AbhinavA10/PS2-RC-Car/docs/Sources/Interfacing a PS2 (PlayStation 2) Controller - CuriousInventor Tutorials_files/annotated_scope.jpg

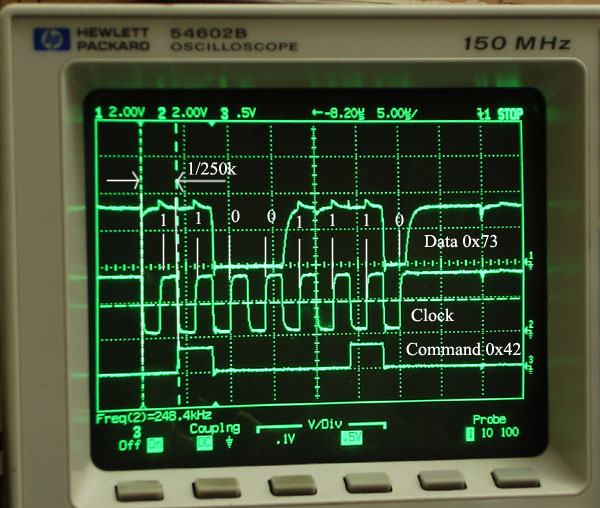
docs/Sources/Interfacing a PS2 (PlayStation 2) Controller - CuriousInventor Tutorials_files/annotated_scope.jpg
