AbhinavA10/PS2-RC-Car/docs/MyNotes/Peripherals on Pins.PDF

## vpn I qL5 1- ffr+ :-

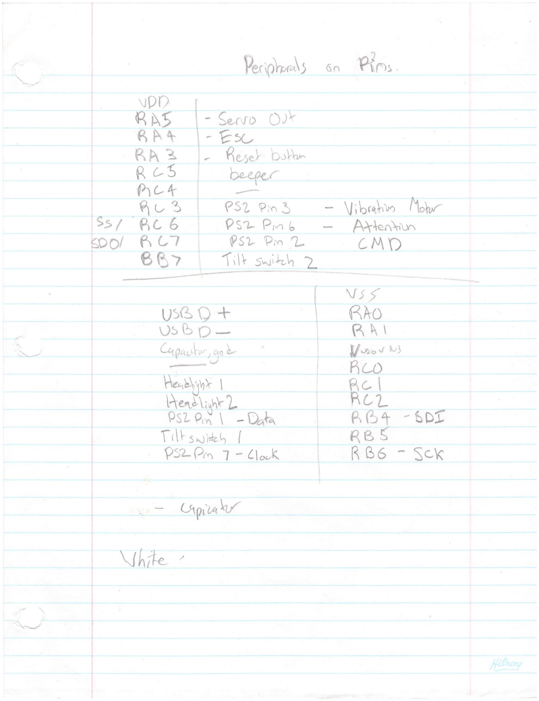
[picture p14: page 1]

F**iphr-\1 Gn Pin,

&h ?. ',-
Ro5
f,\u+

## flu3 5s/ ftc 6

6DC/ fl\ L-l
B [::

Se-r';c O;k
t>t-.
ff a:" i (-.rI)'r,^ 'ry-

P5? P;", $
P sr- Prvr b
fls:. Pin, L
{i\t s*,ii U\ Z

V tbrq!,),r l\"|r"
A\l*nXrn
TMD

-4J
u5eQ+ U:b6l*

(ta,p,,r'\.'
i -\rr c'
*_/

-.P@'i
\4c,,t\rUh I
r\ U
Retf \tnhk L
Fslo,; \ -%l4
fi\f s^.,j*.q t
F:z-P,"r T d (lo,K

(Apit<\f

v5 5"
Rho R\\

$/*, a,I \, )
fiuo
Rct Rr-L

fi t?r t '4 SDt
Re 5
R B5 SCK

V[t* /
