AbhinavA10/PS2-RC-Car/docs/MyNotes/SchematicNotes.PDF

-r

/, | r-t

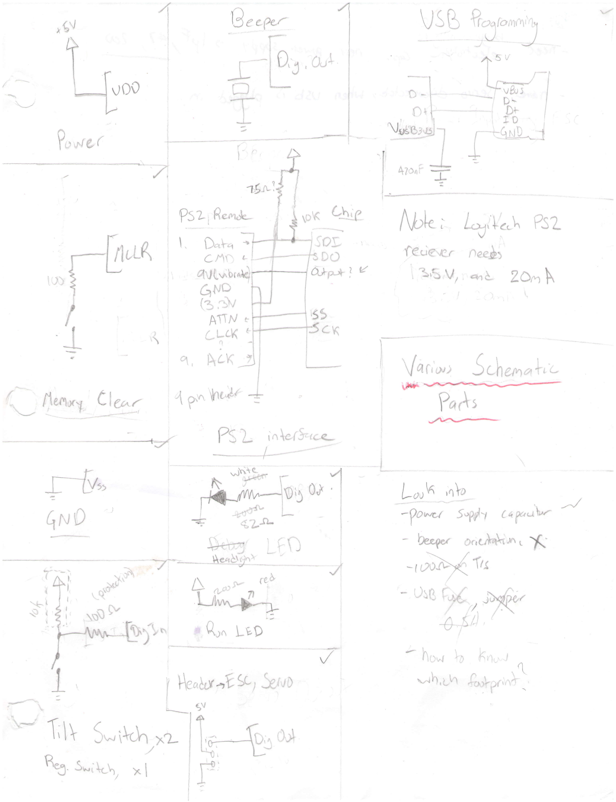
[picture p15: page 1]

t ⁻*i C. li\)

I

n L''

I
t_
\v't//\
,lf ,iq

I

1,'-l

I

r l5ee?.

i

## lI*rl

l. D.,t". ;
C /lt', e- i.
\
{,Jfrabrak)

## VSB

## AlrU ; l-v,'l-c,L Ps?

### feuie"cr nee6:

' A,S,V1. "a4* ZCn", h

l

I

I i l^-. | { i | 1

### ' V Q(i*i )Chen{,,ttt'*

i'f*r o\ t'al5

:\

I

I | ln | \

## lolt -l'i

rq

### 'fo,^a1 S"?d-t tey*rVr

lrk"ryt
-\/

,sr,ul-4\i,.s\ r X

## -rro}-{ Ttl

1-\^i.,{\irW '-1 l-i} t
n
\,/1'\\ vlQ,it1,l-rl1Lu)rr,\4

_

?o*te'(
' '
"-lt
-f.L n-:il I
vJ' | fi
,orr D- t | I J
'Y>L nelvldk"- t J -i | 1e

{
'r, I
i
t
1
:

D"q

i
\

Gt'l? (3 ,..$y'

ATTN

### LLtx

q, hcK'

't ?* htdr

,55
cK

4
0"I'l

t{
f-&"

### / r'rrl ) q/v L/

# &q .it)

:_

* _. Ar4L$: _* -

.-\ )'t'
..idt | + p:'n-n tu'o
1Q'" | | ;"- -n
- 1.. | LJtv\^-+-f-
\\U | ,' -
}ir" .* Ron LED

/
J'
I

\
\ | -r | -{, \:# -\"\t | / | . ,

# lr lt )* iloh

A

I

I
,C,,

I

I
I

I
I
I
I
,' -l

## \oK tIif

'>

15rl! \
*F n0
1o,*r** | s

## ;Yhr

| ile-i
*r
i
)\L

## I R? s*;L\, x I

### ntSL, ftr,;)

,,

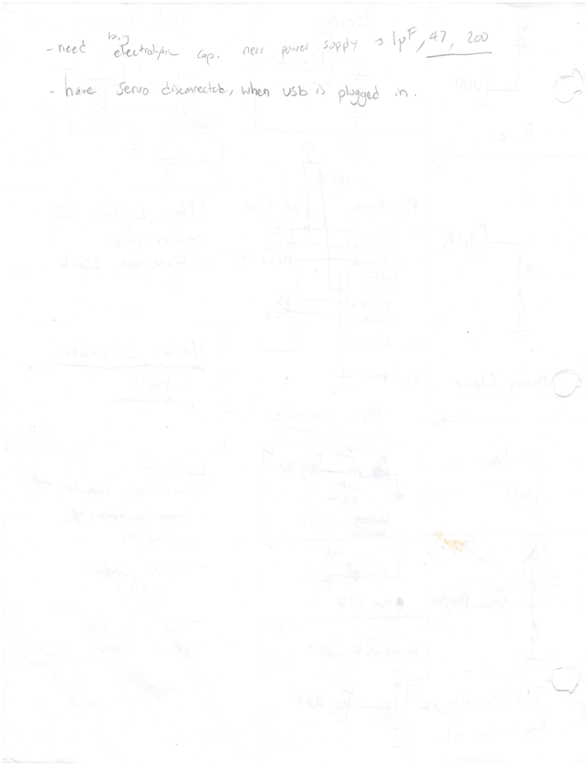
[picture p16: page 2]

nr* d

i
F! *v€*

fiflc f

l"'t\"RJ!

L?r "i
e&.0#ru.l*;1rr* (*,p
"

-krup $t'56anrx"fi\ub",

t # ,r'*b
s*p 6f Y ") \ Y' t a{"V
fi s4}

{ } p\*qqgA ,y\ ,
O\lJ

iUwe'i

u5h

l*J
