AbhinavA10/PS2-RC-Car/docs/MyNotes/WheelDesign.PDF

\ tr€

## .-/'\ t lf_r^n

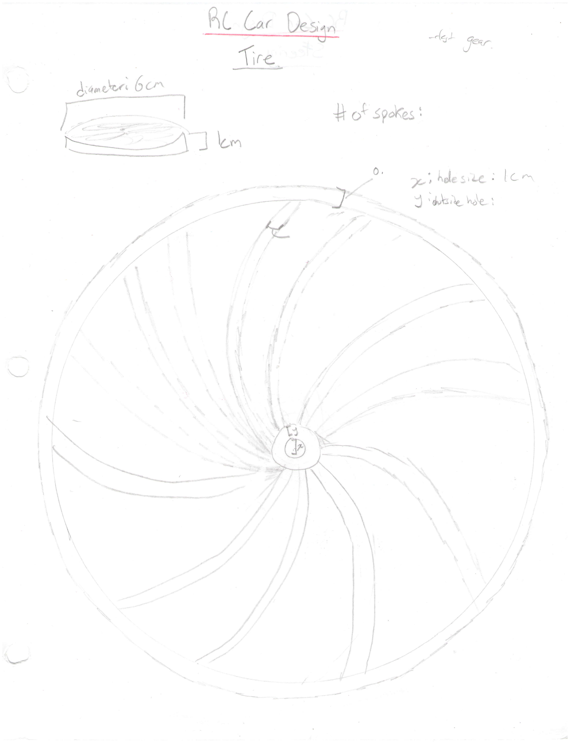
[picture p17: page 1]

_-Qrr
.{, | Fr.

,'/
Ji.r, L'rt(r $6..r"r (-/'

f'-
]
i
t.
I

I'J'

I
I
I
rit'"'! | I
-T } | lJ'

# *$ $p*rcs 1

lal t e'' 'fr.. t fl#lt -'* i ' 11"^ j '6'F*iu h*\e" :

)a 5,J"
H.***

\""I{ J

';i'

I

' 'n.-

i,

\

\

:\

,l

;

,1'';
q,.'f

"^. VJ
,, ,/T-. { ,lr\ .---.-
r | \rl | L' | l
'rA\ | -1,. ' + !. \**f-.r | \
1\ \
1\\. 1'r i".,\ '.\
] | 't | t1
',
| | t,.
t | 't
"

t'

't

1
