AbhinavA10/PS2-RC-Car/docs/MyNotes/Flowchart.PDF

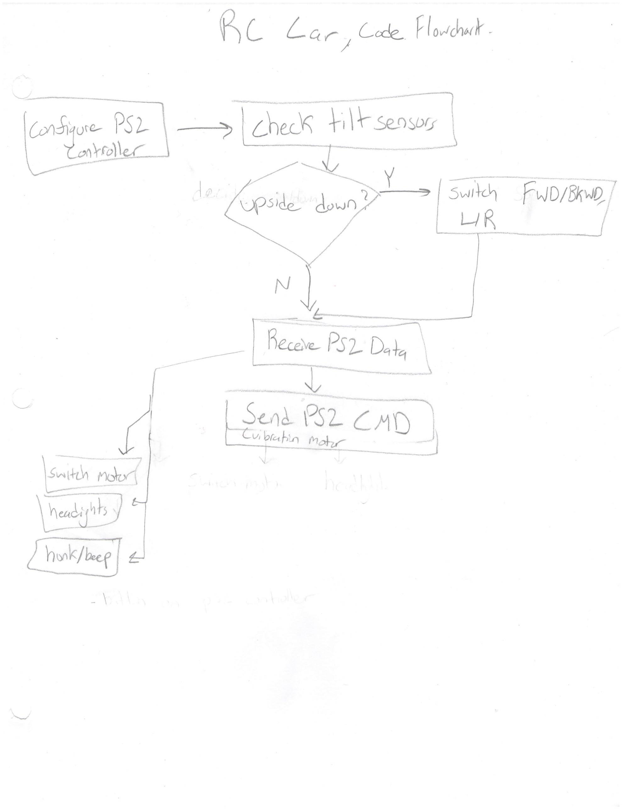
[picture p18: page 1]

fr C- Lar / L"&- ttoa&wk '

'lr
L .5{-rll t?sU- C,^ril-l l- ":kt::_yM *- jj

!

ho^kltuq

r
/
/l It

\r-'iru *hr.,. i
\rffi; i:,n4 L--- r

I

# ffi.)
