AbhinavA10/PS2-RC-Car/docs/MyNotes/PIC16F1459 Pins.PDF

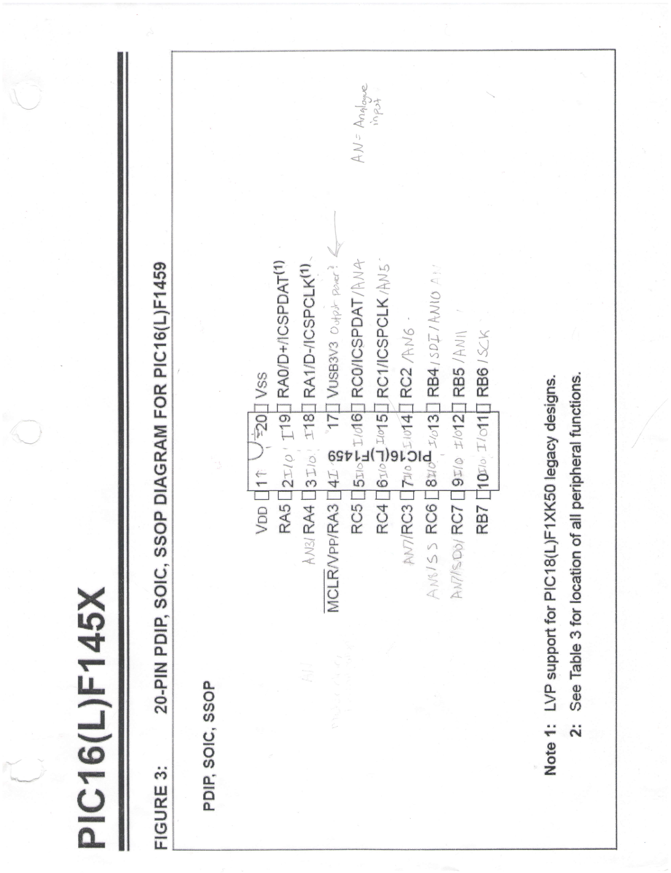
[picture p19: page 1]

SHffi,9 'ffitr #sriH;

ff

:,i.-{* rs tu tc rtr ilt in -tr ,.i*i* | | lR {}*ff ffi{} u ds.
}{;ffi !i* tTI 4Erirl* | *l aq.df | L* {e$ F{s #sfLg

Ii* dt ,g
Hffl
H" -{} {L .dh ff .{ff tf'* F

ft {I} 3#

# d-i

{l} {*r $H

vJ
$) '-.
.'." .<':.

<{*

/
,&' | ;:.
}:p:i;] It B ! ft
| S S5r:{::l.l: pffi,dH &.HlqrE H ffi '3:: fr 4; ' *L
{J f-i C: ff- fl. \o +#n*iffiffi::fizi*, ,qr{,{r,HS'{: HH}; | ?{i
rr1 ffi4**#HFfi.| | =g{f,}fs ffiq{{S{JuL}ffiffiHl btrHlFtrm{trffiffitH
ra t,{*l * fry U,'? qf fr} 'fS f** F"* ffiq{d{{(JU#t-}t-}ffi FtrtrffiffiffiSffffim# ' :, | .+5. .l | [& | -\ *invt'.)

-<( .ry |

*'i- s i

^.d Iu" | '_
. i- lJ | I' lq: | I

tqIid.

ft- trffi

{f}
sf m

{f,
tr*r*ra

ET&

Sffi tr* fS TT | Tfi r\ | r'.

., SSF [di r
HH
A
t{t S :ffi

tri
ffH

h*1
fV.
tfp
'.1-
{-r

ffi qf

*tu
,ir#+ J'lti*l.i ffi t

f#
fiL
ff#

[.t H
tr
r$$

ffi &
ffi
T} ffi

'Jffi
ffi
fift
trft

il$
fL. H

ah#
f,if

IIJ
ffi 3
ffi

ffi
il.L

Hffi qf

TE- d\E# ffi r

## ffi

ffi&
