AbhinavA10/PS2-RC-Car/docs/MyNotes/Peripherals on Pins.JPG

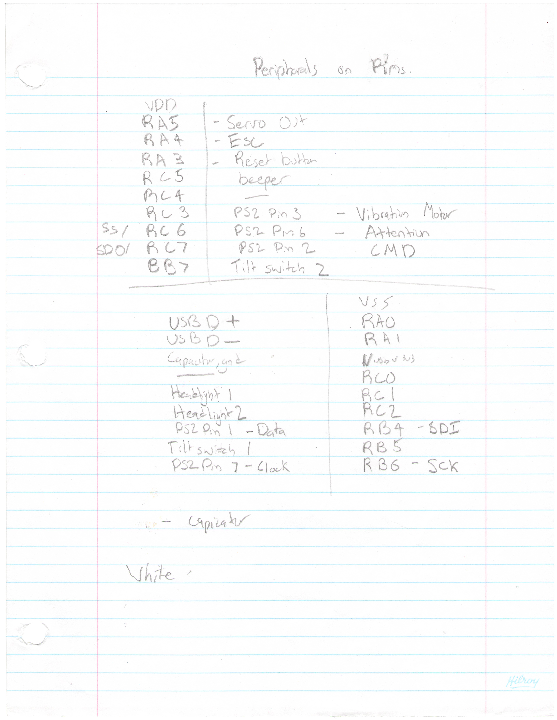
docs/MyNotes/Peripherals on Pins.JPG
