AbhinavA10/PS2-RC-Car/docs/MyNotes/SchematicNotes1.JPG

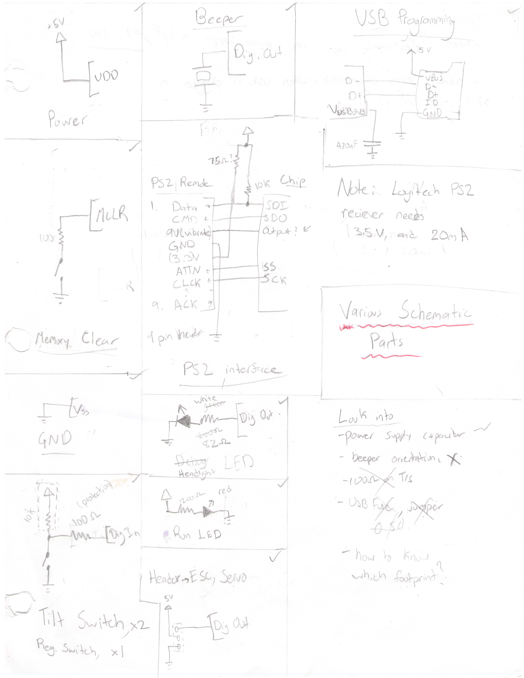
docs/MyNotes/SchematicNotes1.JPG
