AbhinavA10/PS2-RC-Car/docs/MyNotes/SchematicNotes2.JPG

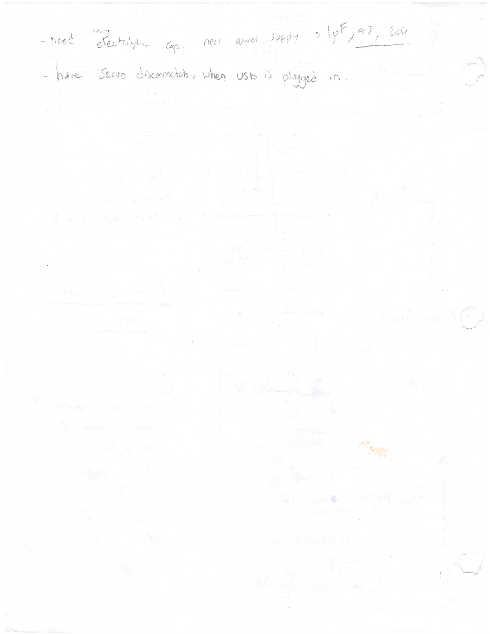
docs/MyNotes/SchematicNotes2.JPG
