AbhinavA10/PS2-RC-Car/docs/MyNotes/Upside Down RC Vehicle - 1st design.JPG

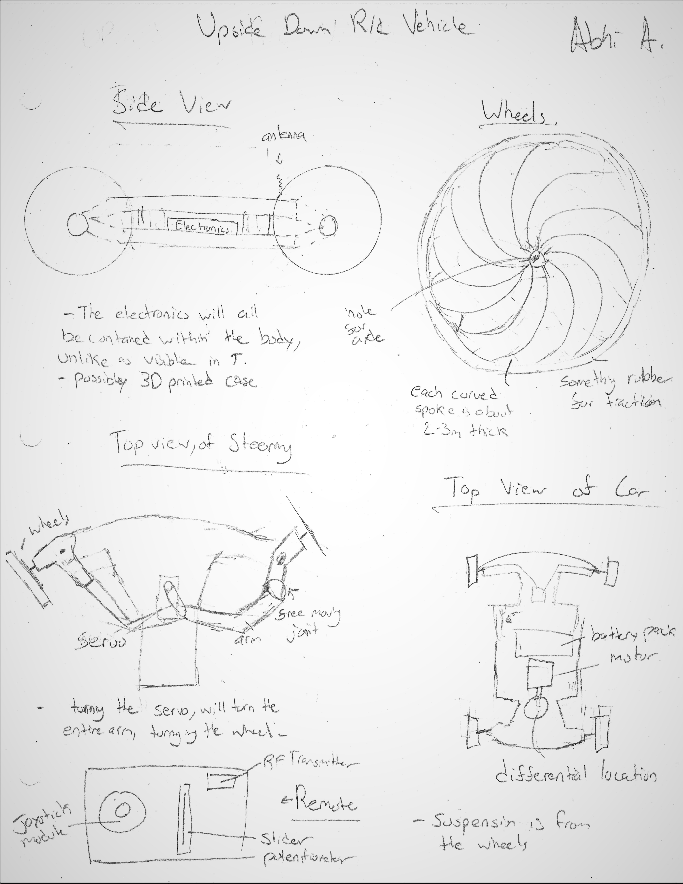
docs/MyNotes/Upside Down RC Vehicle - 1st design.JPG
