AbhinavA10/PS2-RC-Car/docs/MyNotes/WheelDesign.JPG

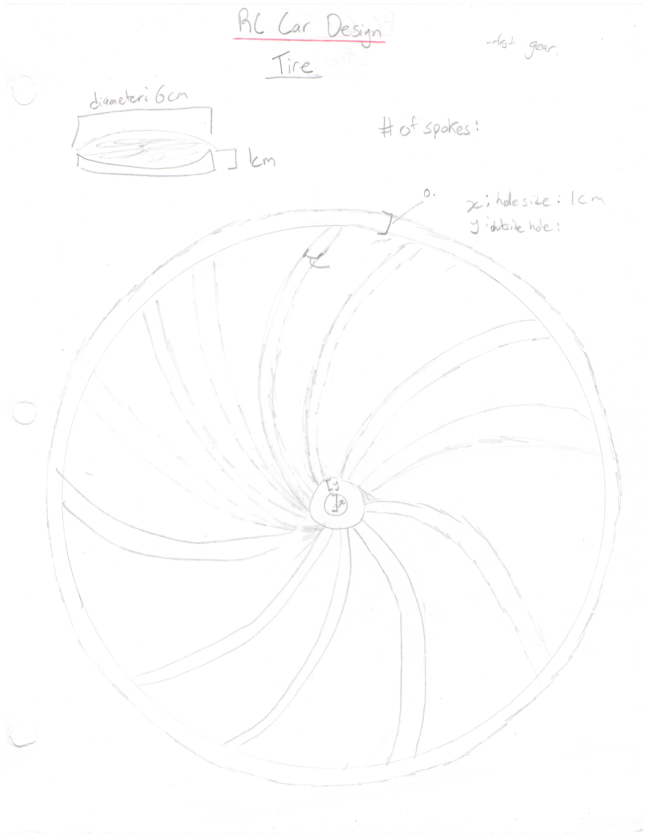
docs/MyNotes/WheelDesign.JPG
