AbhinavA10/PS2-RC-Car/docs/Sources/PS2-pins-2.jpg

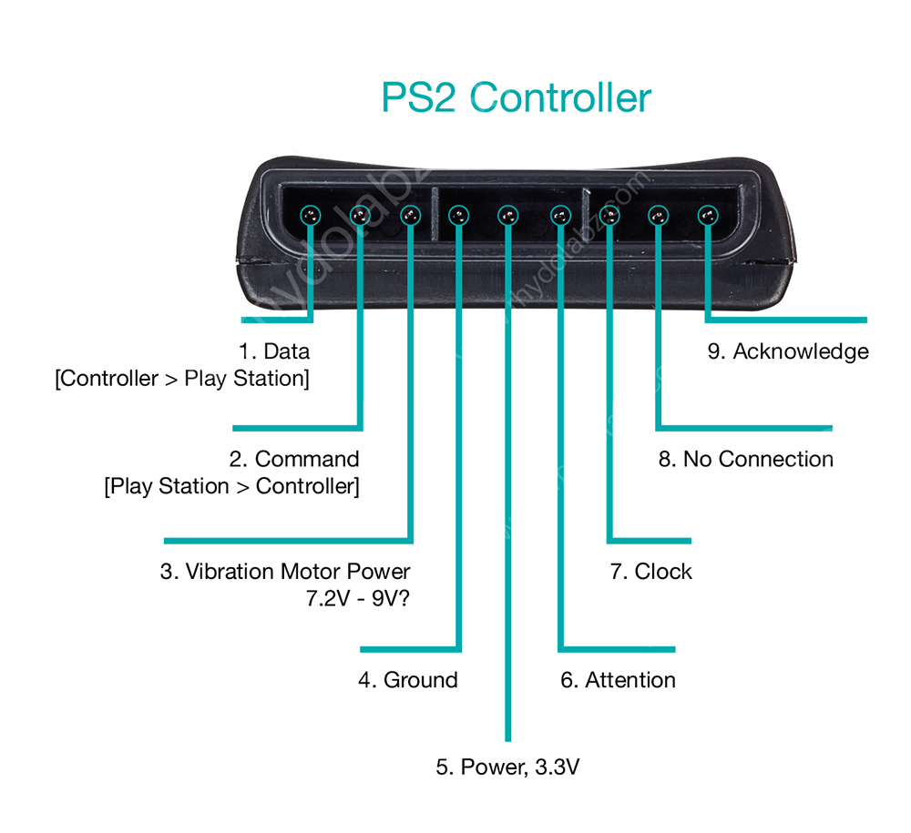
docs/Sources/PS2-pins-2.jpg
