AbhinavA10/PS2-RC-Car/images_other/CircuitDesign_completed/circuit copper layer.png

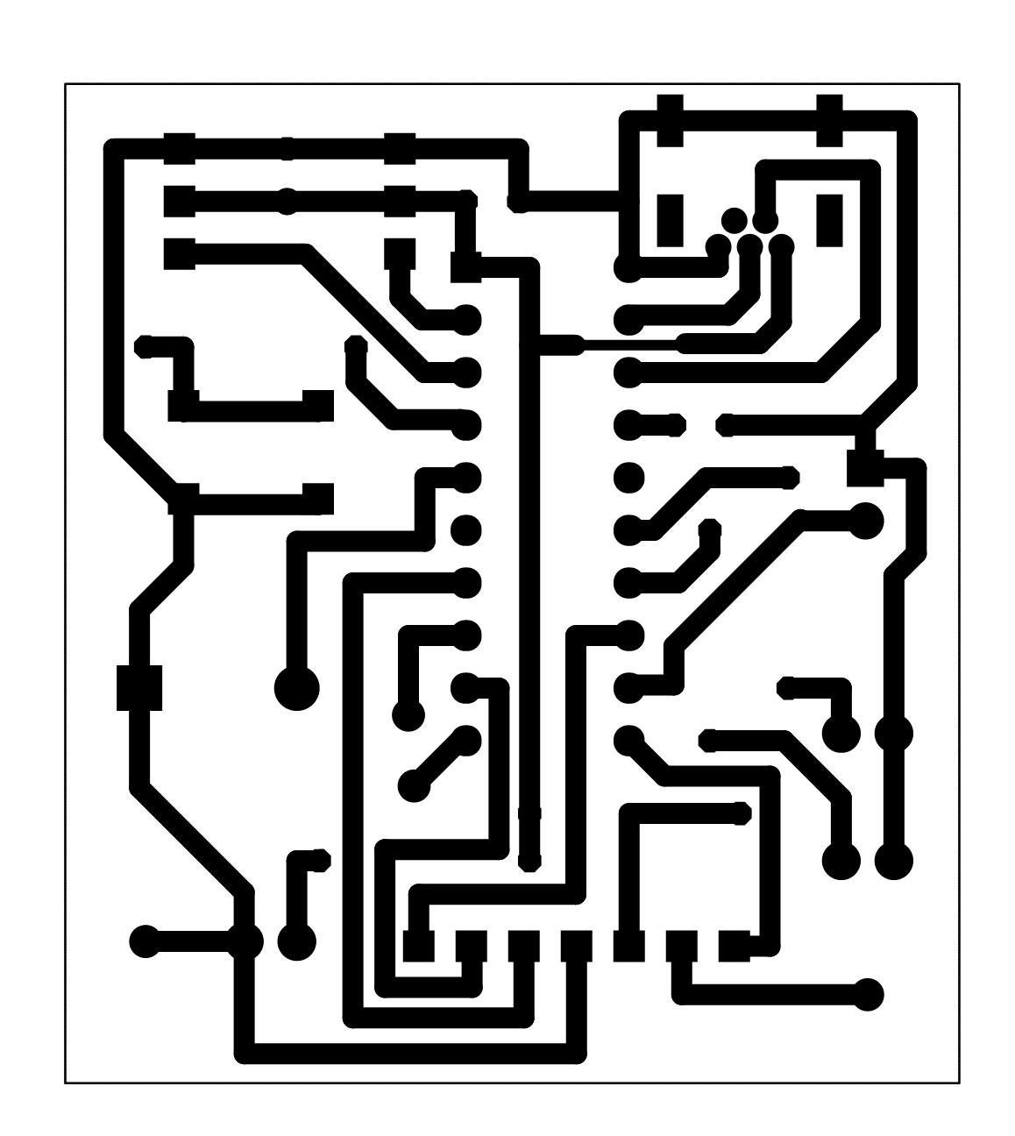
images_other/CircuitDesign_completed/circuit copper layer.png
