AbhinavA10/PS2-RC-Car/images_other/CircuitDesign_completed/V2.PNG

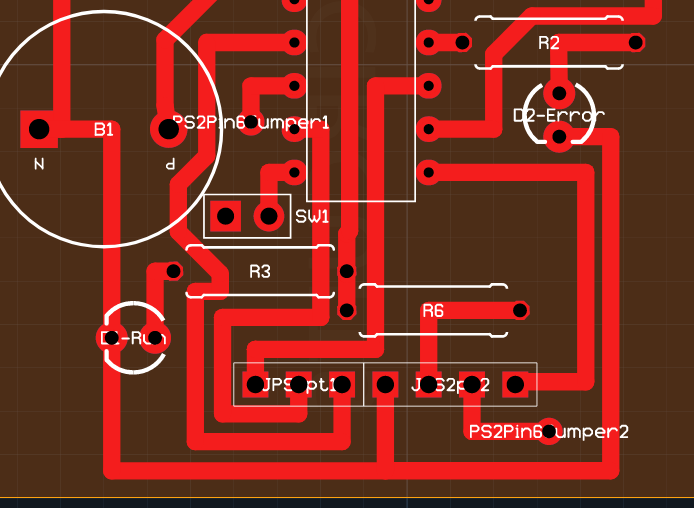
images_other/CircuitDesign_completed/V2.PNG
