AbhinavA10/PS2-RC-Car/images_other/IMG_20180110_105214.jpg

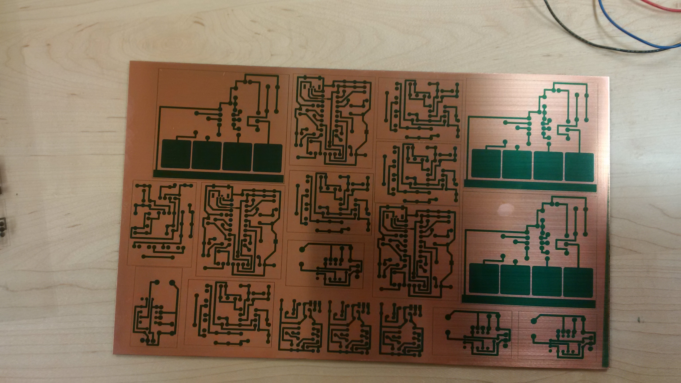
images_other/IMG_20180110_105214.jpg
