AbhinavA10/PS2-RC-Car/images_other/IMG_20180111_100513.jpg

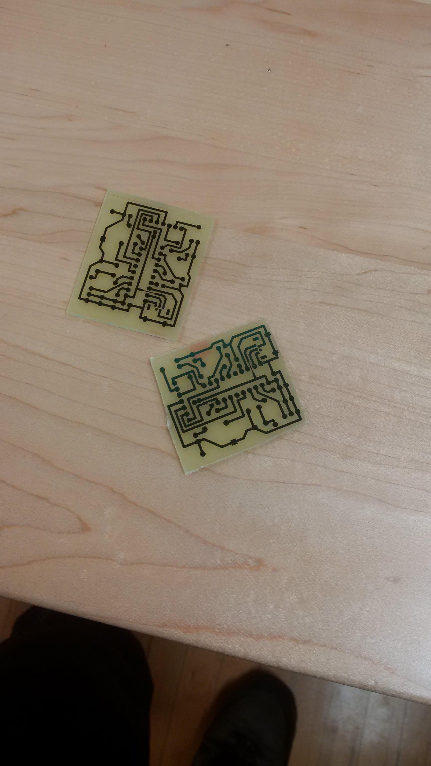
images_other/IMG_20180111_100513.jpg
