AbhinavA10/PS2-RC-Car/images_other/IMG_20180111_201627.jpg

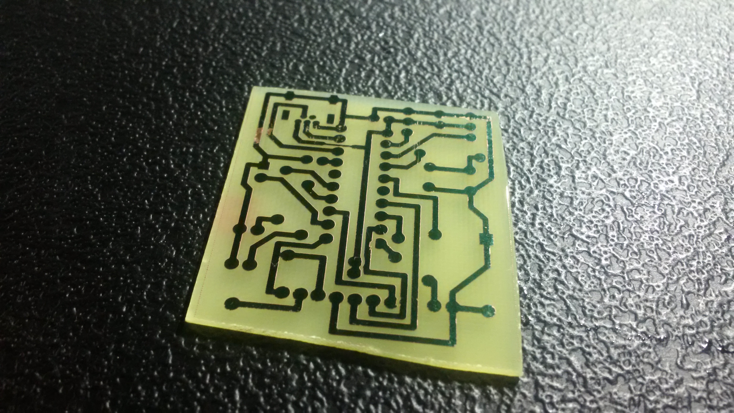
images_other/IMG_20180111_201627.jpg
