AbhinavA10/PS2-RC-Car/images_other/IMG_20180112_101816.jpg

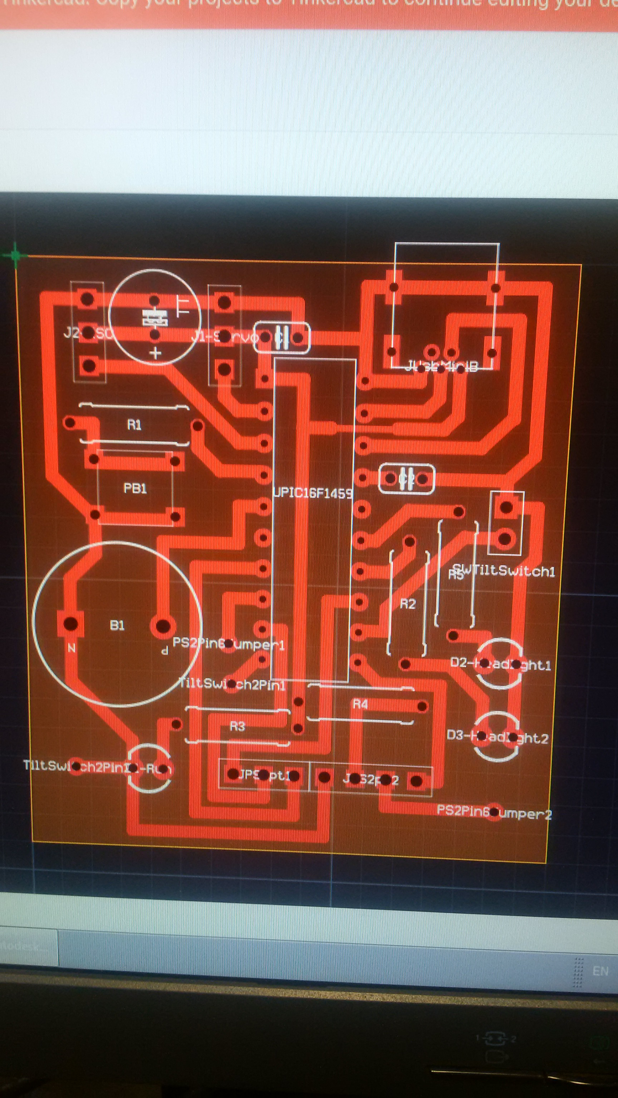
images_other/IMG_20180112_101816.jpg
