AbhinavA10/PS2-RC-Car/images_other/IMG_20180116_151600.jpg

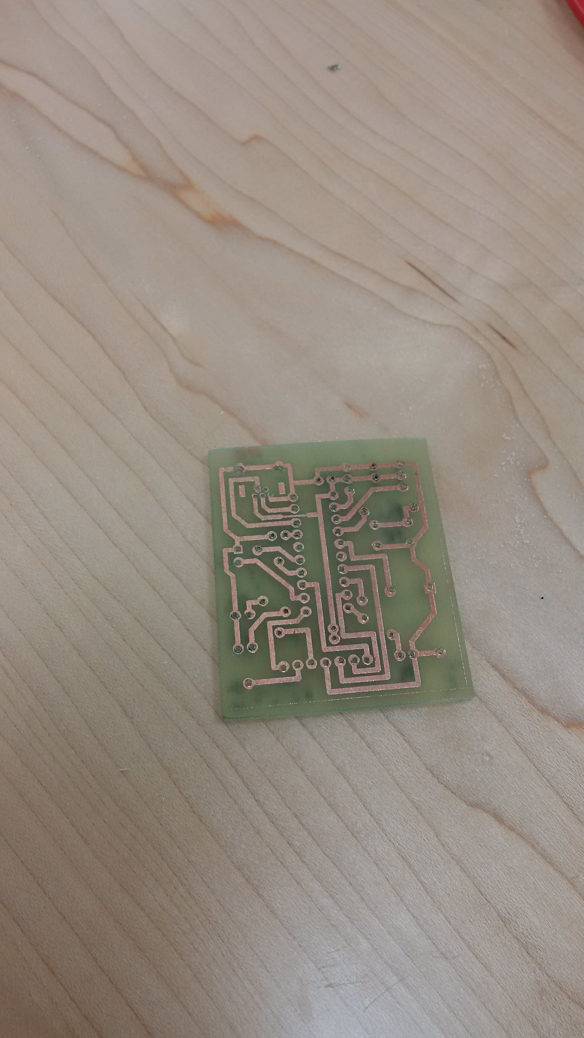
images_other/IMG_20180116_151600.jpg
