AbhinavA10/PS2-RC-Car/images_other/IMG_20180123_000927.jpg

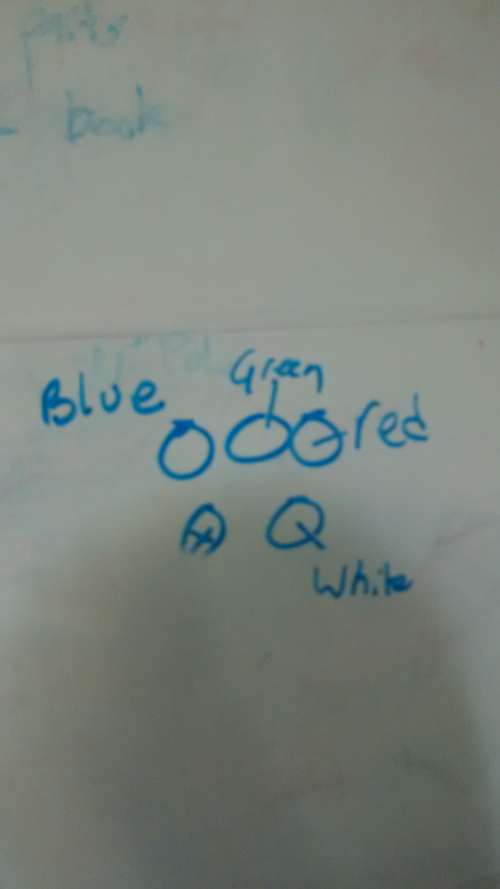
images_other/IMG_20180123_000927.jpg
