AbhinavA10/PS2-RC-Car/images_other/IMG_20180123_105321.jpg

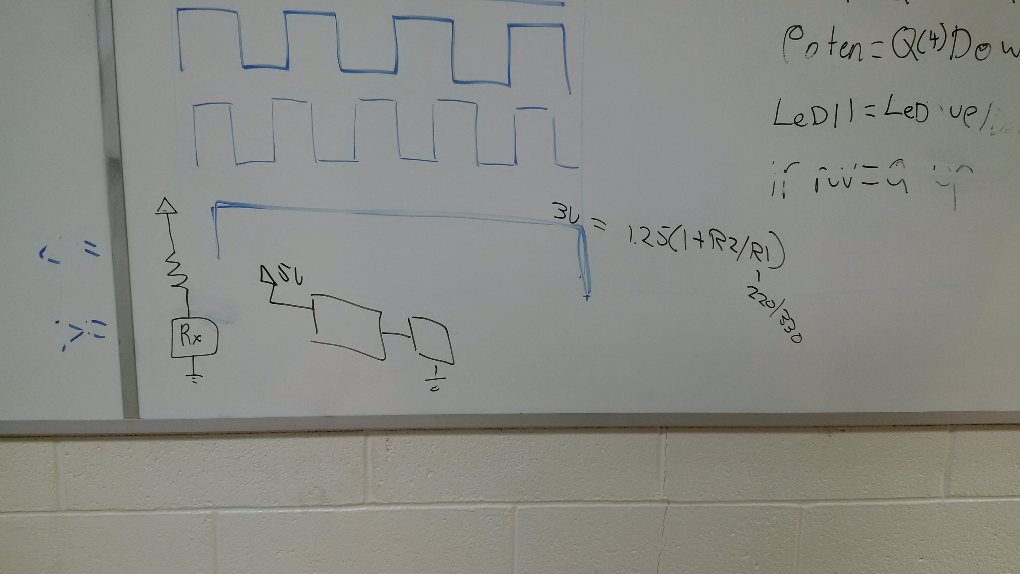
images_other/IMG_20180123_105321.jpg
