AbhinavA10/PS2-RC-Car/images_other/IMG_20180123_151143.jpg

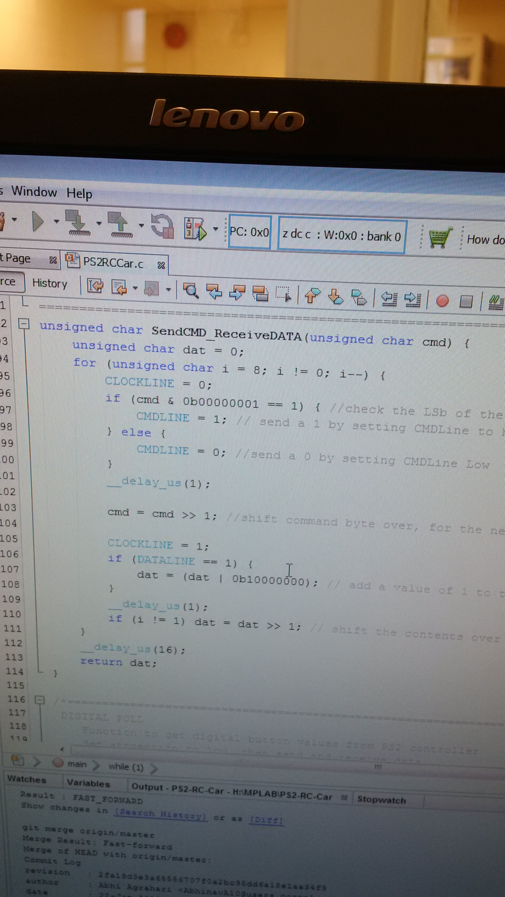
images_other/IMG_20180123_151143.jpg
