AbhinavA10/PS2-RC-Car/images_other/interface1.jpg

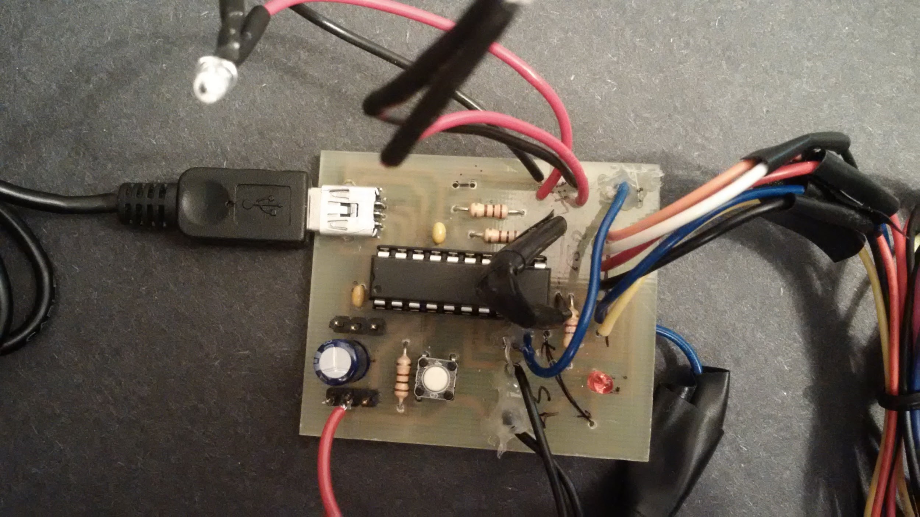
images_other/interface1.jpg
