AbhinavA10/PS2-RC-Car/images_other/interface2.jpg

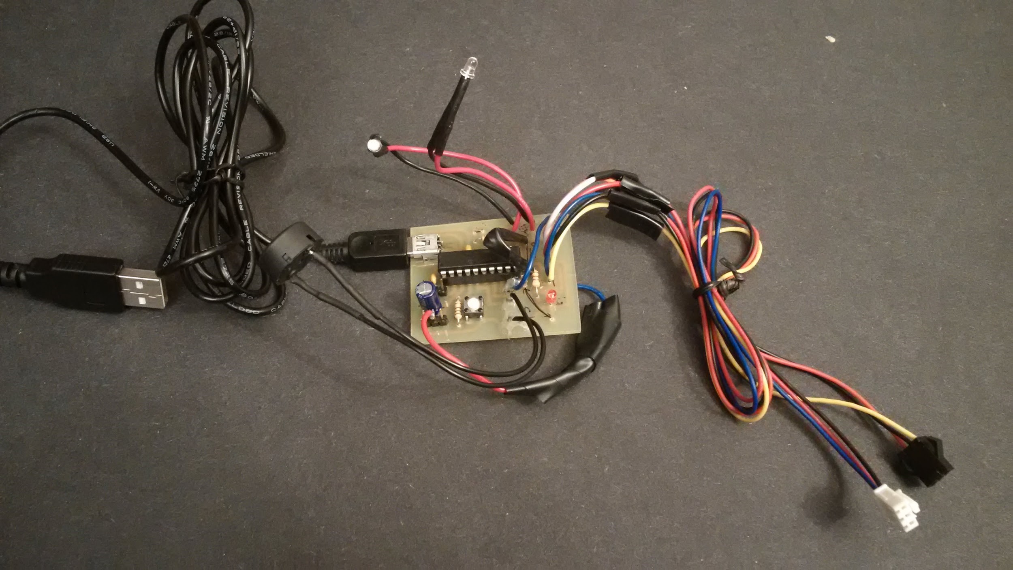
images_other/interface2.jpg
