AbhinavA10/PS2-RC-Car/images_other/interface3.jpg

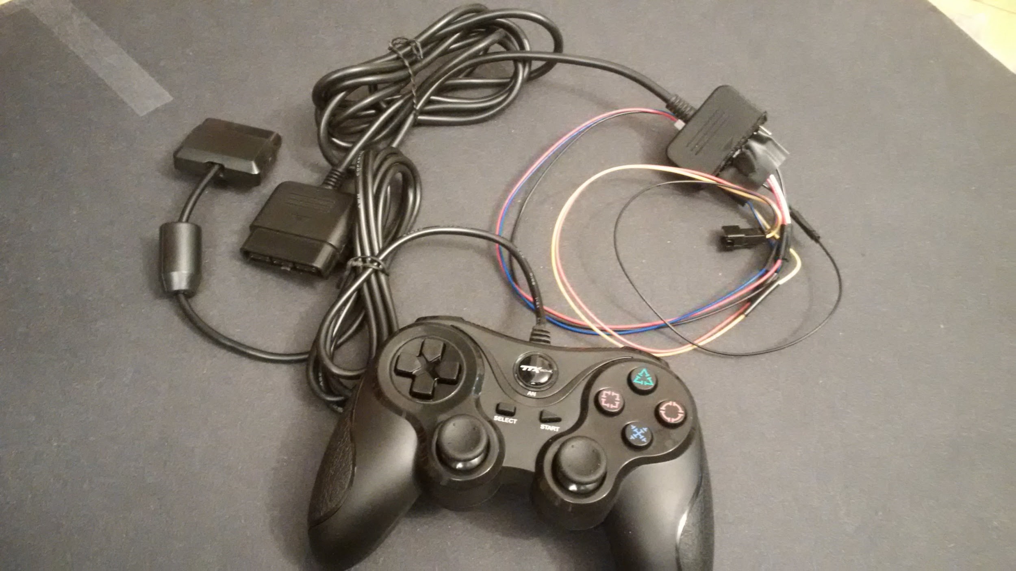
images_other/interface3.jpg
