AbhinavA10/PS2-RC-Car/images_other/Oscilloscope readings/EntireProtocol_Merged/01_beginning.png

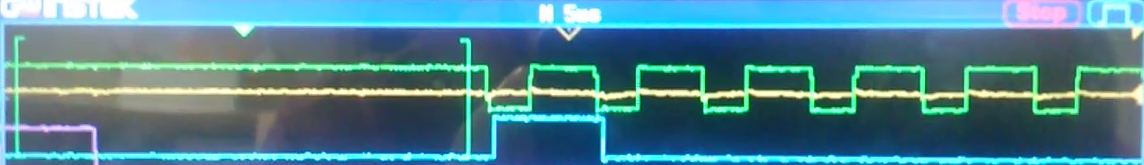
images_other/Oscilloscope readings/EntireProtocol_Merged/01_beginning.png
