AbhinavA10/PS2-RC-Car/images_other/Oscilloscope readings/EntireProtocol_Merged/03_Byte2.png

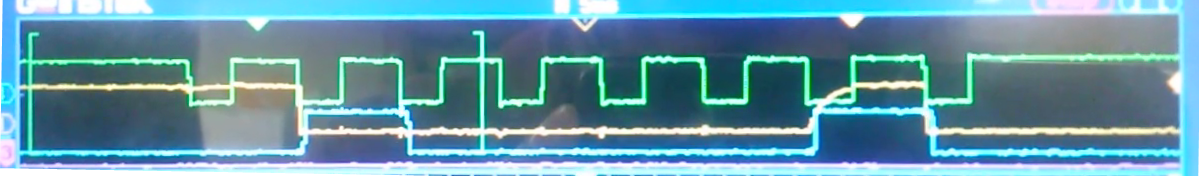
images_other/Oscilloscope readings/EntireProtocol_Merged/03_Byte2.png
