AbhinavA10/PS2-RC-Car/images_other/Oscilloscope readings/EntireProtocol_Merged/04_Byte3.png

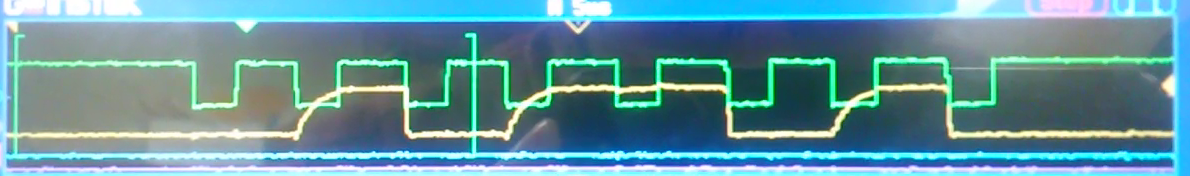
images_other/Oscilloscope readings/EntireProtocol_Merged/04_Byte3.png
