AbhinavA10/PS2-RC-Car/images_other/Oscilloscope readings/EntireProtocol_Merged/05_Byte4.png

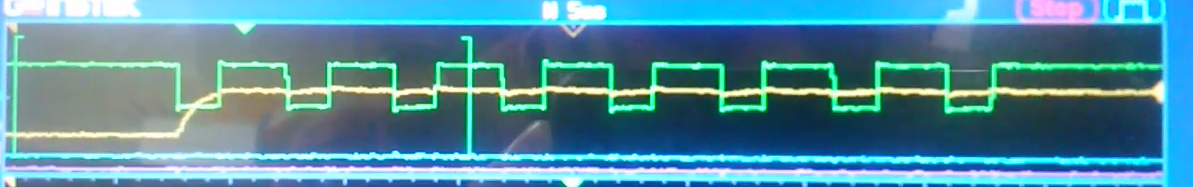
images_other/Oscilloscope readings/EntireProtocol_Merged/05_Byte4.png
