AbhinavA10/PS2-RC-Car/images_other/Oscilloscope readings/EntireProtocol_Merged/06_Byte5.png

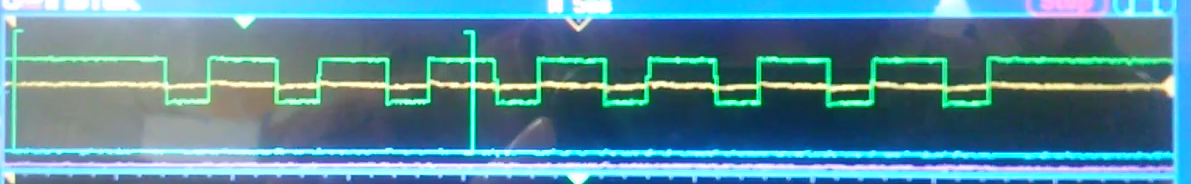
images_other/Oscilloscope readings/EntireProtocol_Merged/06_Byte5.png
