AbhinavA10/PS2-RC-Car/images_other/Oscilloscope readings/EntireProtocol_Merged/07_Space.png

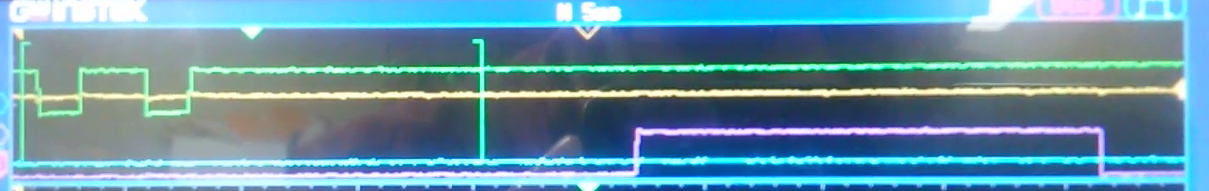
images_other/Oscilloscope readings/EntireProtocol_Merged/07_Space.png
