AbhinavA10/PS2-RC-Car/images_other/Oscilloscope readings/EntireProtocol_Merged/combined - fixing.png

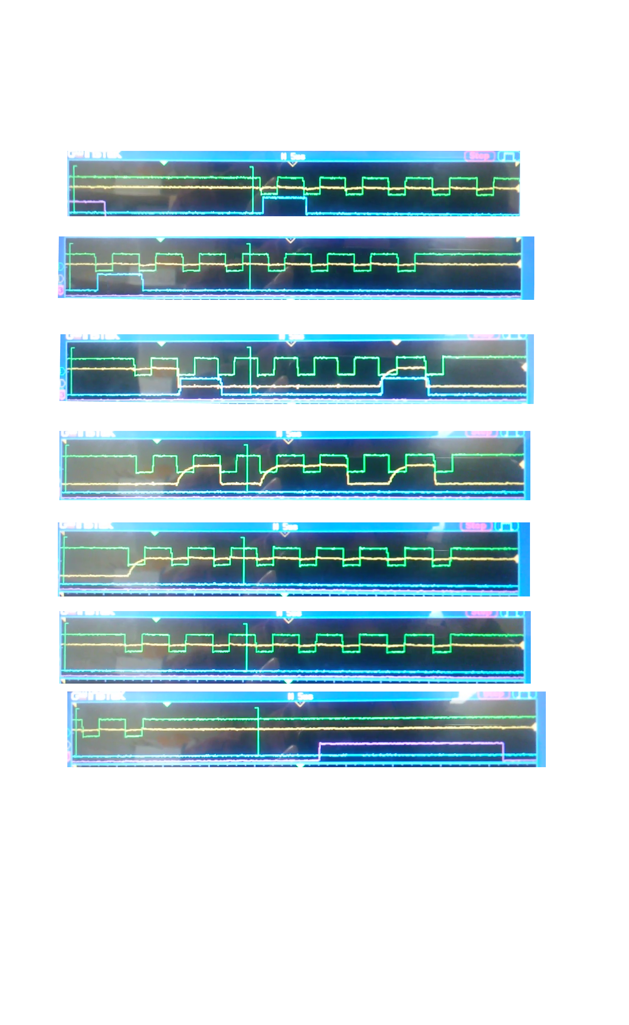
images_other/Oscilloscope readings/EntireProtocol_Merged/combined - fixing.png
