AbhinavA10/PS2-RC-Car/images_other/Oscilloscope readings/EntireProtocol_Merged/combined - rotated.png

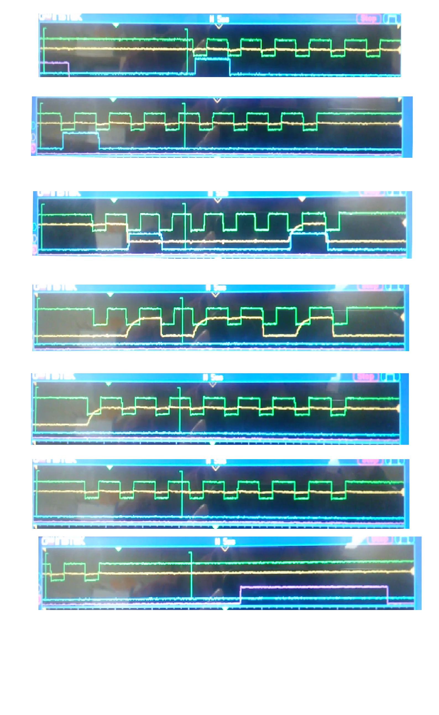
images_other/Oscilloscope readings/EntireProtocol_Merged/combined - rotated.png
