AbhinavA10/PS2-RC-Car/images_other/Oscilloscope readings/IMG_20180123_154846.jpg

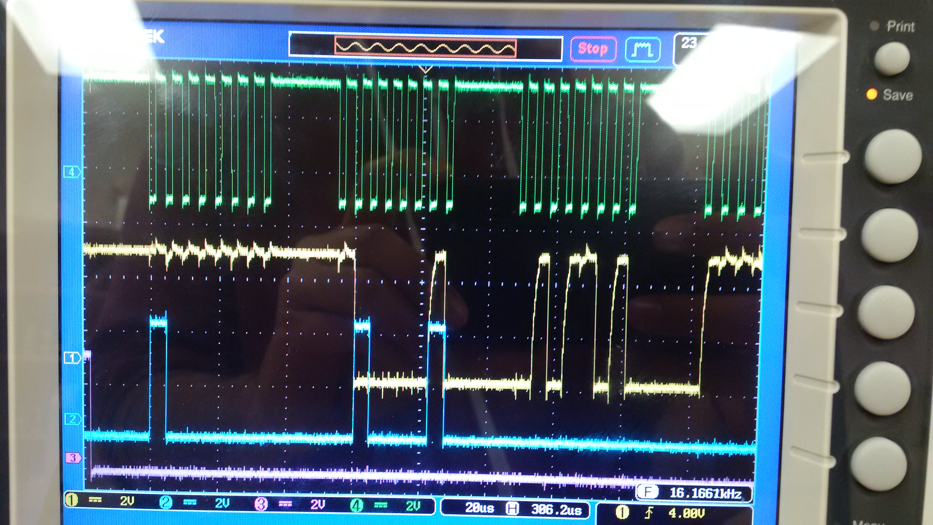
images_other/Oscilloscope readings/IMG_20180123_154846.jpg
