AbhinavA10/PS2-RC-Car/images_other/Oscilloscope readings/IMG_20180123_155412.jpg

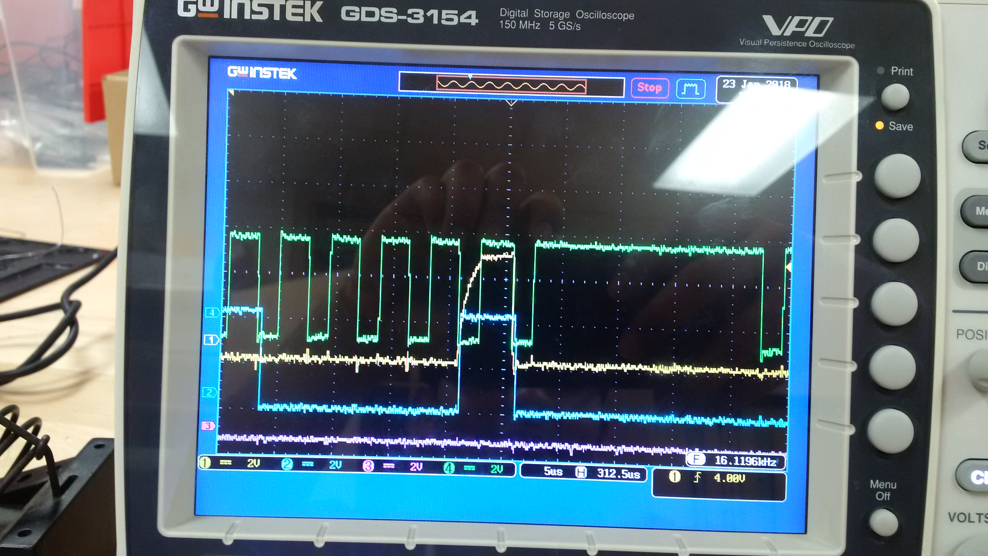
images_other/Oscilloscope readings/IMG_20180123_155412.jpg
