AbhinavA10/PS2-RC-Car/images_other/Oscilloscope readings/ScreenShots/02_Byte1.png

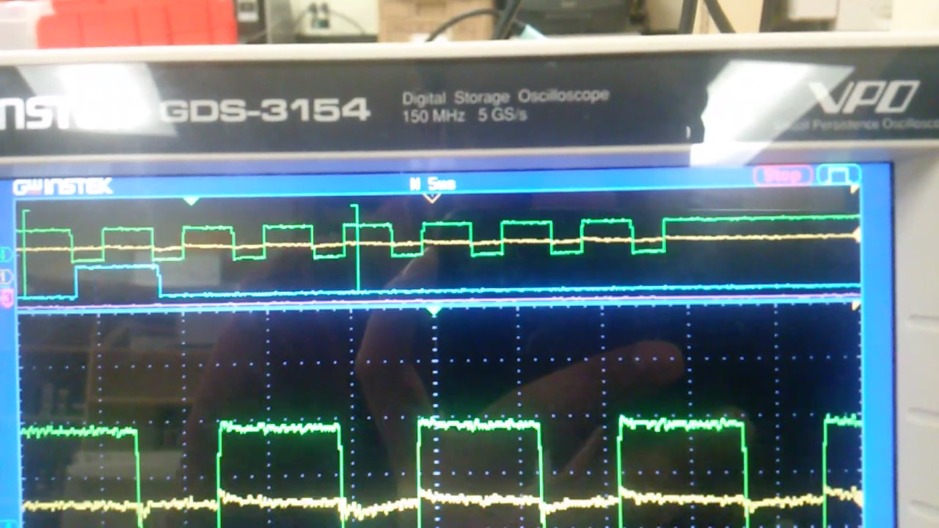
images_other/Oscilloscope readings/ScreenShots/02_Byte1.png
