AbhinavA10/PS2-RC-Car/images_other/Oscilloscope readings/ScreenShots/03_Space.png

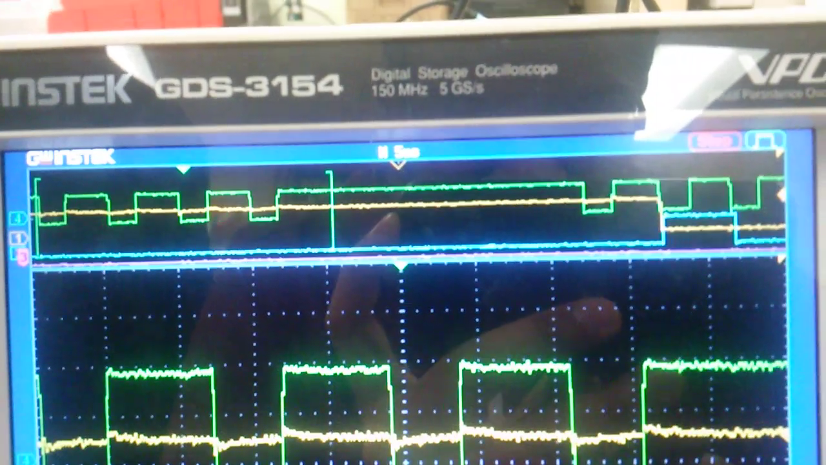
images_other/Oscilloscope readings/ScreenShots/03_Space.png
