AbhinavA10/PS2-RC-Car/images_other/Oscilloscope readings/ScreenShots/04_Byte2.png

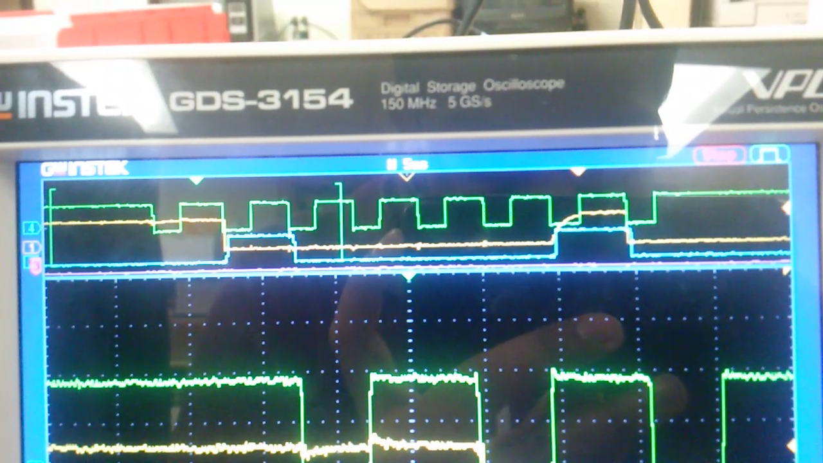
images_other/Oscilloscope readings/ScreenShots/04_Byte2.png
