AbhinavA10/PS2-RC-Car/images_other/Oscilloscope readings/ScreenShots/06_Byte3.png

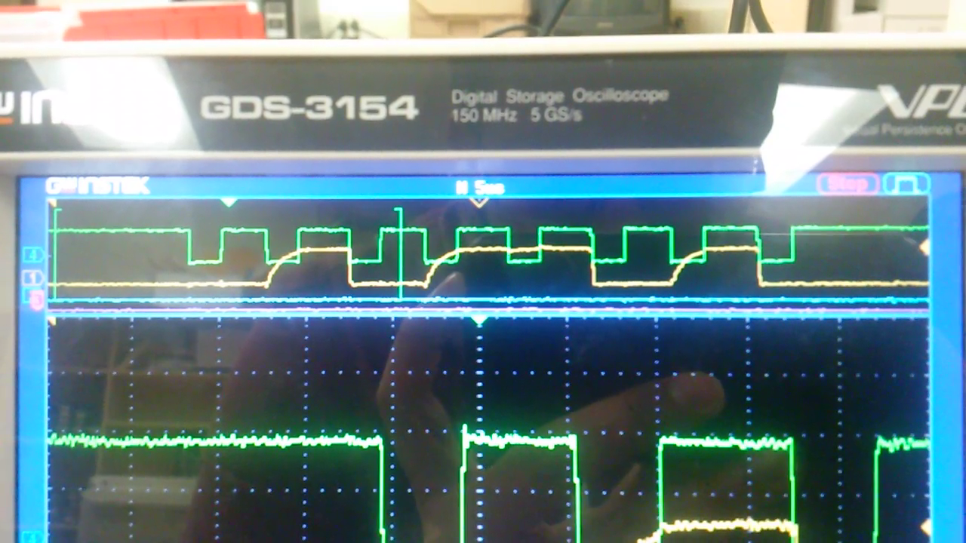
images_other/Oscilloscope readings/ScreenShots/06_Byte3.png
