AbhinavA10/PS2-RC-Car/images_other/Oscilloscope readings/ScreenShots/07_Space.png

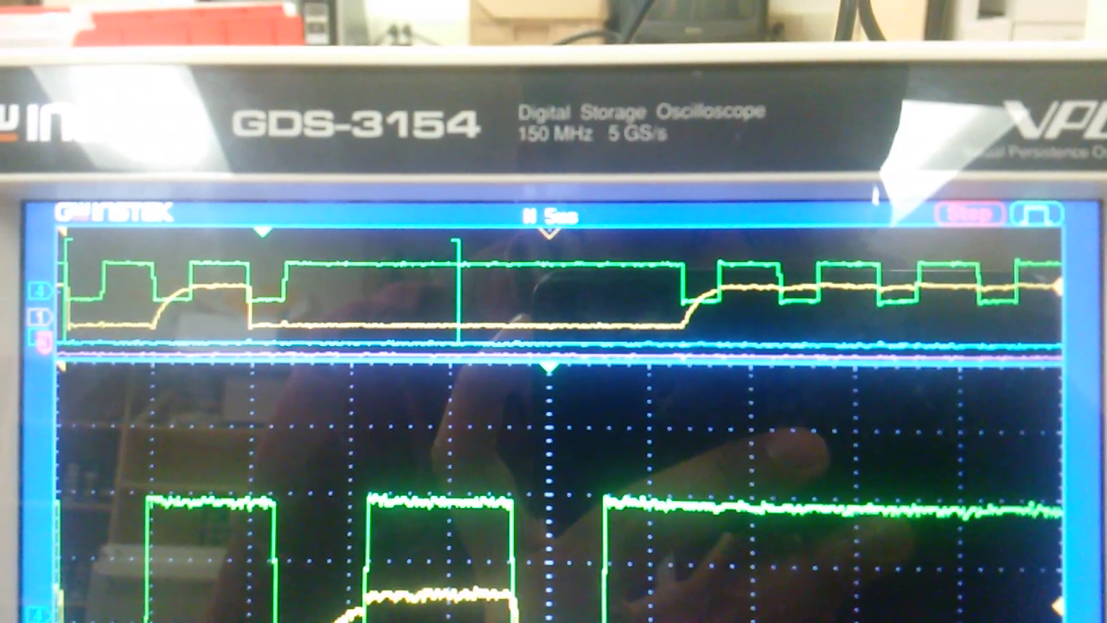
images_other/Oscilloscope readings/ScreenShots/07_Space.png
