AbhinavA10/PS2-RC-Car/images_other/Oscilloscope readings/ScreenShots/10_Byte5.png

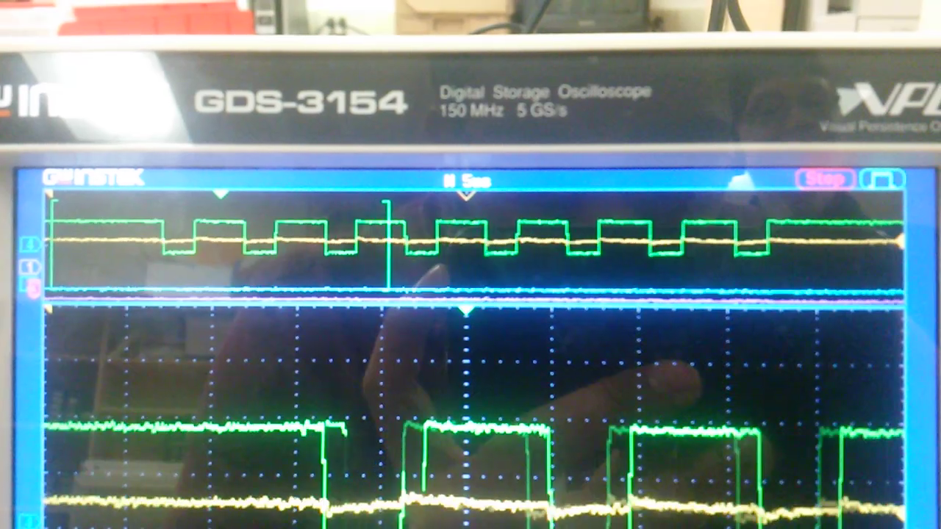
images_other/Oscilloscope readings/ScreenShots/10_Byte5.png
