AbhinavA10/PS2-RC-Car/images_other/wheelv1_actual.jpg

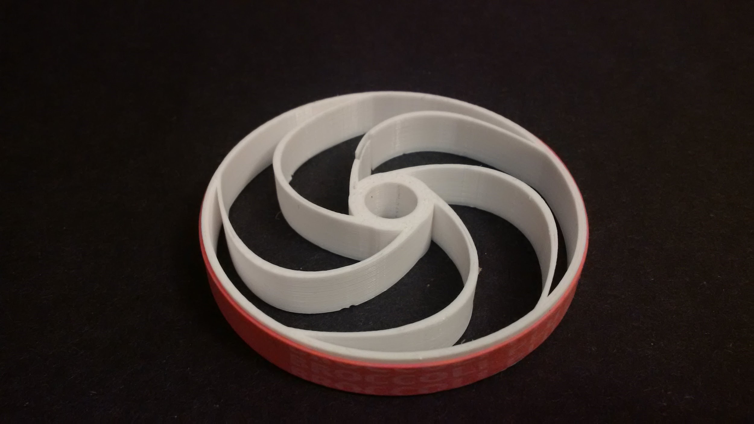
images_other/wheelv1_actual.jpg
