AbhinavA10/PS2-RC-Car/images_other/wheelv2_actual.jpg

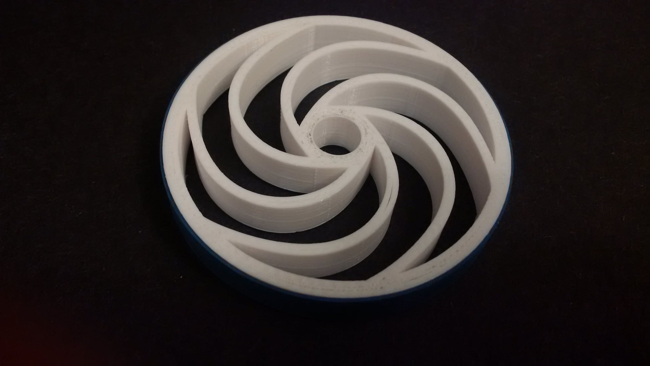
images_other/wheelv2_actual.jpg
