AbhinavA10/PS2-RC-Car/docs/STL_TireDesign/Tire V2.stl

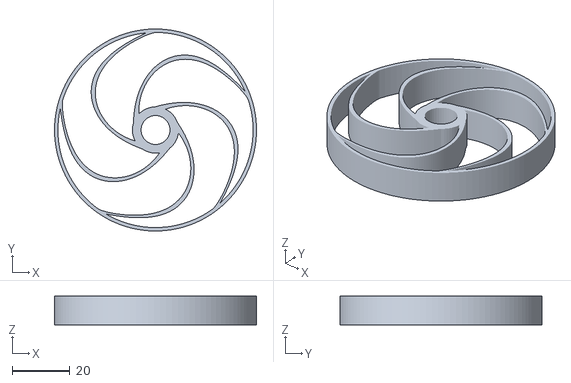
[picture p76: CAD file, 2018-12-17]
docs/STL_TireDesign/Tire V2.stl
70.0 x 70.0 x 10.0
