AbhinavA10/PS2-RC-Car/docs/STL_TireDesign/Tire V1.stl

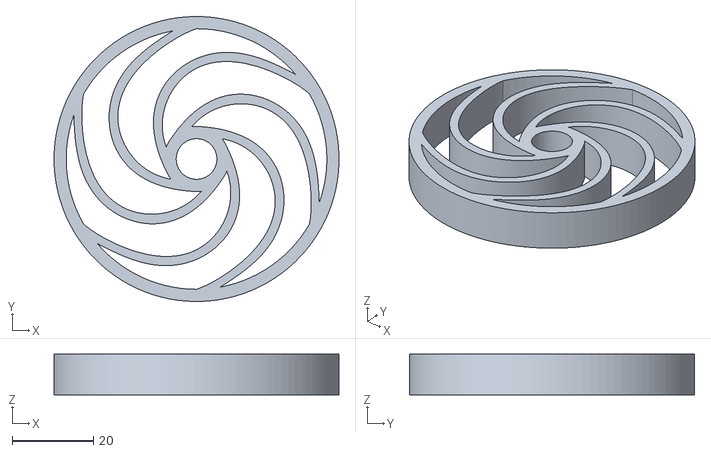
[picture p77: CAD file, 2018-12-17, an earlier design]
docs/STL_TireDesign/Tire V1.stl
70.0 x 70.0 x 10.0
