AbhinavA10/PS2-RC-Car/docs/Sources/Interfacing a PS2 (PlayStation 2) Controller - CuriousInventor Tutorials_files/scope_att_cmd_dat_clk_gh_30.jpg

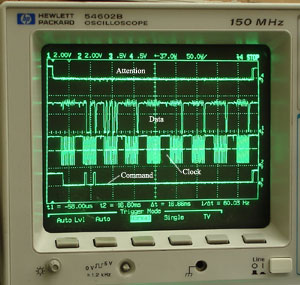
docs/Sources/Interfacing a PS2 (PlayStation 2) Controller - CuriousInventor Tutorials_files/scope_att_cmd_dat_clk_gh_30.jpg
