AbhinavA10/PS2-RC-Car/docs/Sources/Interfacing a PS2 (PlayStation 2) Controller - CuriousInventor Tutorials_files/Soldering_Iron_Stand.jpg

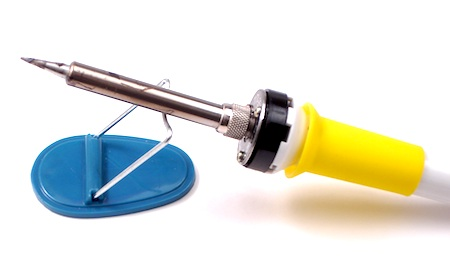
docs/Sources/Interfacing a PS2 (PlayStation 2) Controller - CuriousInventor Tutorials_files/Soldering_Iron_Stand.jpg
