AbhinavA10/PS2-RC-Car/images_other/Oscilloscope readings/IMG_20180123_160241_Setup2.jpg

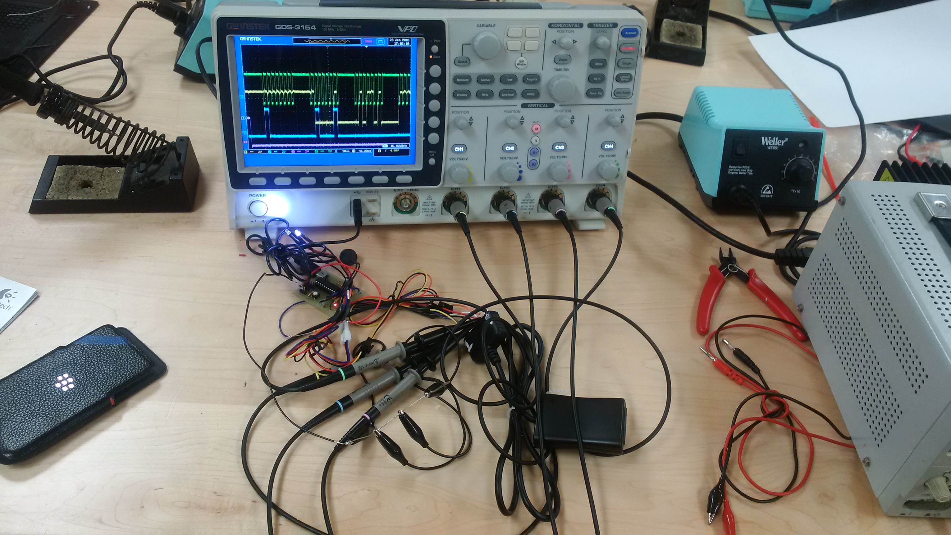
images_other/Oscilloscope readings/IMG_20180123_160241_Setup2.jpg
