AbhinavA10/PS2-RC-Car/(commit log)

2018-01-08 Created PS2 Protocol code, and readme
    - Added all sources, including my notes, and external pdfs. Also includes CurioursInventor's old website (since no longer hosted)
    - Created readme, and researched PS2 Protocol
    - After researching protocol, I created the PS2RCCar.c file, which has all the code to implement the protocol in the PIC16F1459 microcontroller
    - updated port/tris registers
    [PIC16F1459config.c, PS2RCCar.c, RCCar.c, RCCar.h]
2018-01-09 Verified PS2 protocol against CuriousInventor’s
    Verified protocol, updated readme, and started pressure value configuration code
2018-01-15 Added pressure return values, and fixed comments
    [PS2RCCar.c, RCCar.c]
2018-01-21 Tested beep code. Etched Board functions!
2018-01-23 changed Dataline pullup resistor to external. Signal is more square
2018-01-24 Wired Controller Works!
2018-01-25 Analog joystick turns servo
2018-12-17 Added report and pics of PCB
    [Tire V1.stl, Tire V2.stl]
2021-09-24 Update PCB design note
